ben-hawks/yet-another-smart-vent/docs/images/battery-vent-open-underside.png

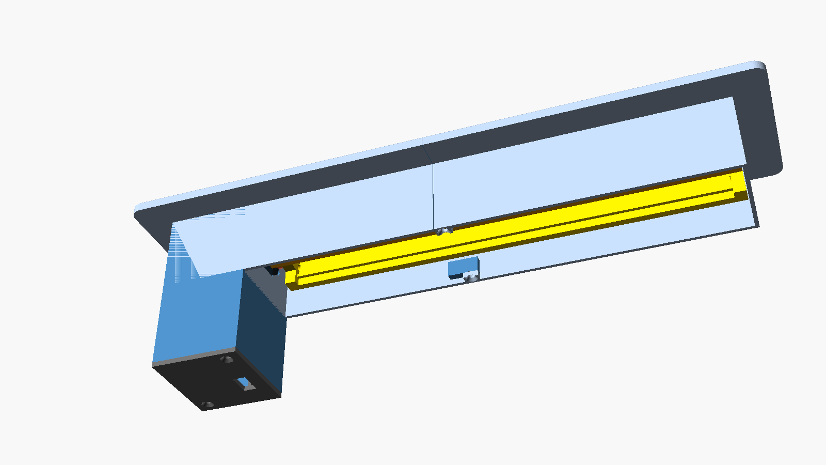
docs/images/battery-vent-open-underside.png
