ben-hawks/yet-another-smart-vent/hardware/xiao-backpack/fab/placement-top.png

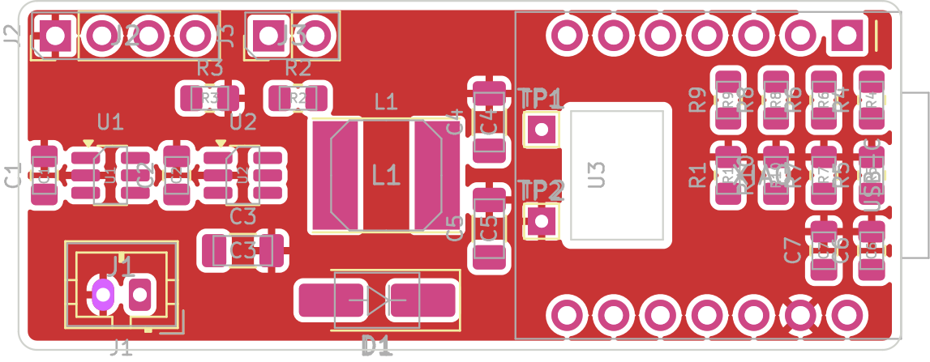
hardware/xiao-backpack/fab/placement-top.png
