ben-hawks/yet-another-smart-vent/docs/bom-10-vents.csv

Group | Reference | Part | Per vent | Qty for 10 | Source | Distributor PN | MPN | Unit price (USD) | Price basis | Notes
Main |  | Seeed XIAO ESP32-C6 | 1 | 10 | DigiKey | 1597-113991254-ND | 113991254 | 5.38 | qty 1
Main |  | Servo metal gear analog feedback (rated -15..70C) | 1 | 10 | Alibaba |  | Feetech FT90M-FB | 6.00 | approx | Must be the 4-wire -FB version
Main |  | Protected 18650 3400mAh button top | 1 | 10 | liionwholesale.com | SW34PCB | Sinowatt SW18650-34MP | 6.37 | qty 10 (user quote) | 69.1 x 18.6 mm; out of stock on 2026-11-01
Main |  | 18650 holder with wire leads | 1 | 10 | DigiKey |  | MPD BH-18650-W | 3.64 | check | Verify protected-cell fit
Main |  | Limit switch | 1 | 10 | DigiKey | P10865S-ND | Panasonic ESE-11HS2 | 0.376 | qty 10
PCB |  | Backpack PCB 48x19mm 2-layer | 1 | 10 | JLCPCB/PCBWay/OSH Park |  |  |  | check | Gerbers in hardware/xiao-backpack/fab/gerbers
PCB | U1 | Load switch | 1 | 10 | DigiKey | 296-50498-1-ND | TI TPS22917DBVR | 0.407 | qty 10
PCB | U2 | Boost converter | 1 | 12 | LCSC | C84817 | MT3608 |  | check | Not stocked by DigiKey
PCB | L1 | 10uH 4.6A Isat shielded 6x6 | 1 | 10 | DigiKey | SRN6045TA-100MCT-ND | Bourns SRN6045TA-100M | 0.408 | qty 10
PCB | D1 | Schottky 40V 3A SMA | 1 | 10 | DigiKey |  | Diodes Inc B340A-13-F | 0.54 | check
PCB | C3 C4 C5 | 22uF 10V X5R 1206 | 3 | 30 | DigiKey | 1276-1287-1-ND | Samsung CL31A226KPHNNNE | 0.283 | qty 10 | 0.188 @100
PCB | C1 | 1uF 25V X7R 0805 | 1 | 20 | DigiKey | 1276-1066-1-ND | Samsung CL21B105KAFNNNE | 0.059 | qty 10
PCB | C6 C7 | 100nF 50V X7R 0805 | 2 | 30 | DigiKey | 1276-1003-1-ND | Samsung CL21B104KBCNNNC | 0.045 | qty 10
PCB | R1 R4 R5 | 1M 1% 0805 | 3 | 50 | DigiKey | 311-1.00MCRCT-ND | Yageo RC0805FR-071ML | 0.034 | qty 10 | 0.017 @100
PCB | R2 | 51k 1% 0805 | 1 | 20 | DigiKey |  | Yageo RC0805FR-0751KL |  | check
PCB | R3 | 6.8k 1% 0805 | 1 | 20 | DigiKey |  | Yageo RC0805FR-076K8L |  | check
PCB | R9 | 1k 1% 0805 | 1 | 20 | DigiKey |  | Yageo RC0805FR-071KL |  | check
PCB | R10 | 100k 1% 0805 | 1 | 20 | DigiKey |  | Yageo RC0805FR-07100KL |  | check
PCB | R6 | 10k 1% 0805 | 1 | 20 | DigiKey |  | Yageo RC0805FR-0710KL |  | check | servo feedback divider
PCB | R7 | 20k 1% 0805 | 1 | 20 | DigiKey |  | Yageo RC0805FR-0720KL |  | check | servo feedback divider
PCB | R8 | 330R 1% 0805 | 1 | 20 | DigiKey |  | Yageo RC0805FR-07330RL |  | check
PCB | J1 | JST PH 2-pin vertical header | 1 | 12 | DigiKey |  | JST B2B-PH-K-S(LF)(SN) | 0.12 | check
PCB |  | JST PH 2-pin housing | 1 | 12 | DigiKey |  | JST PHR-2 | 0.10 | check | For the battery holder lead
PCB |  | JST PH crimp contact | 2 | 30 | DigiKey |  | JST SPH-002T-P0.5S | 0.04 | check | Needs crimper; or solder leads into J1
PCB |  | 1x40 male breakaway header 2.54mm straight | 0.5 | 5 | DigiKey |  | Pololu 965 (or similar) | 0.95 | qty 1 | XIAO pins (soldered directly)
PCB | J2 J3 | 1x40 male header 2.54mm right-angle | 0.2 | 2 | DigiKey |  |  |  | check | 6 pins per board
Hardware |  | M3 heat-set insert 4.6OD x 5.7mm | 9 | 90 | on hand
Hardware |  | M3x8 flat-head screw | 6 | 60 | McMaster/Amazon |  |  |  | check
Hardware |  | M3x10 flat-head screw | 2 | 20 | McMaster/Amazon |  |  |  | check
Hardware |  | M3x16 flat-head screw | 1 | 10 | McMaster/Amazon |  |  |  | check
Hardware |  | ASA or PETG filament | 0.15 kg | 1.5 kg | any |  |  |  | estimate | Not PLA (furnace heat)
