ben-hawks/yet-another-smart-vent/cad/stl/lid.stl

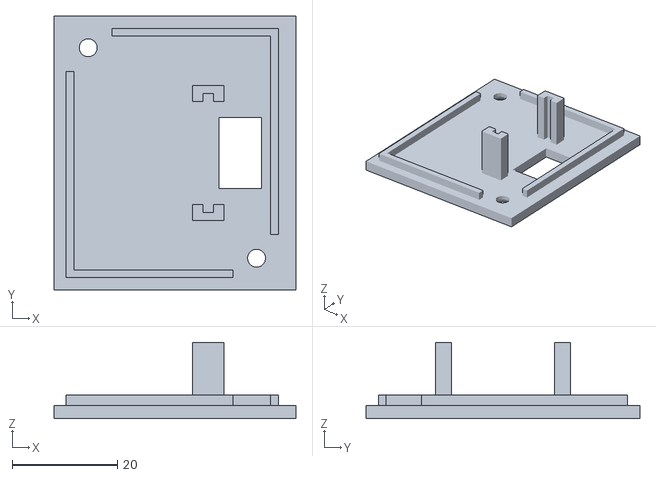
[picture p9: CAD file, 2026-11-01]
cad/stl/lid.stl
46.0 x 52.0 x 14.5
