ben-hawks/yet-another-smart-vent/cad/stl/round6/slat2.stl

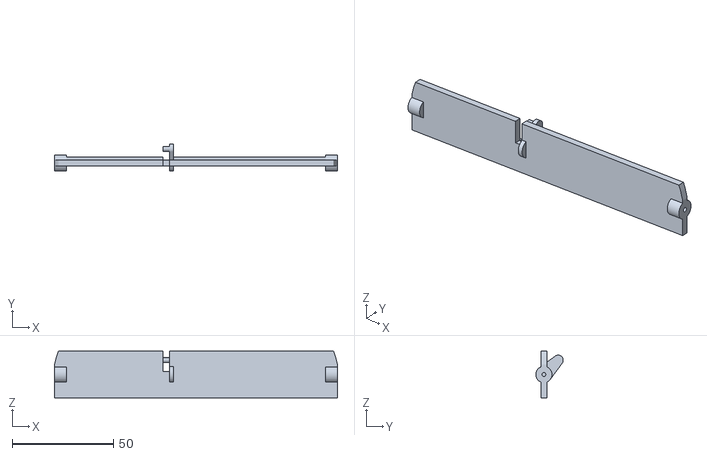
[picture p10: CAD file, 2026-11-01]
cad/stl/round6/slat2.stl
139.8 x 13.6 x 23.0
