ben-hawks/yet-another-smart-vent/cad/stl/body_left.stl

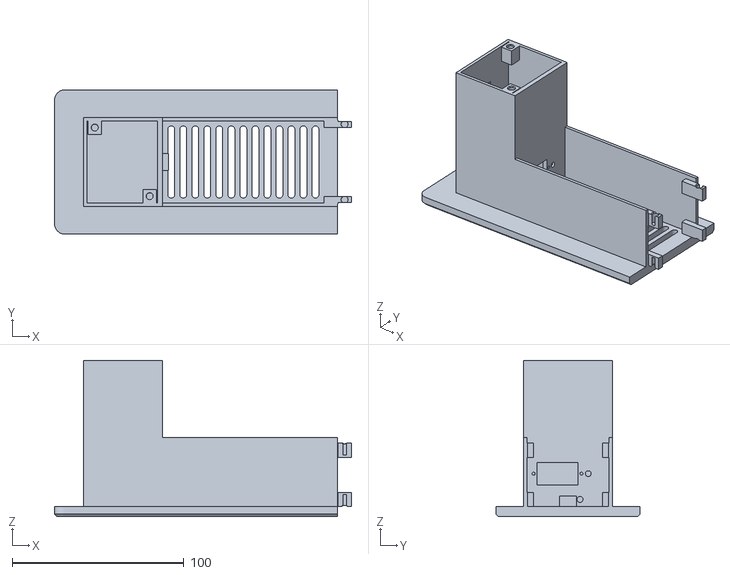
[picture p11: CAD file, 2026-11-01]
cad/stl/body_left.stl
173.0 x 84.0 x 91.0
