ben-hawks/yet-another-smart-vent/cad/stl/round6/slat5.stl

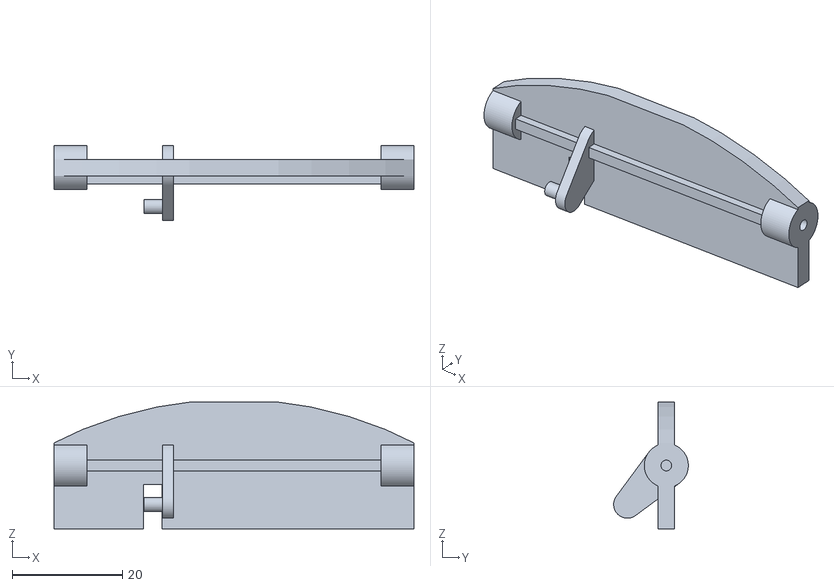
[picture p12: CAD file, 2026-11-01]
cad/stl/round6/slat5.stl
65.4 x 13.6 x 23.0
