ben-hawks/yet-another-smart-vent/cad/stl/louver_follower.stl

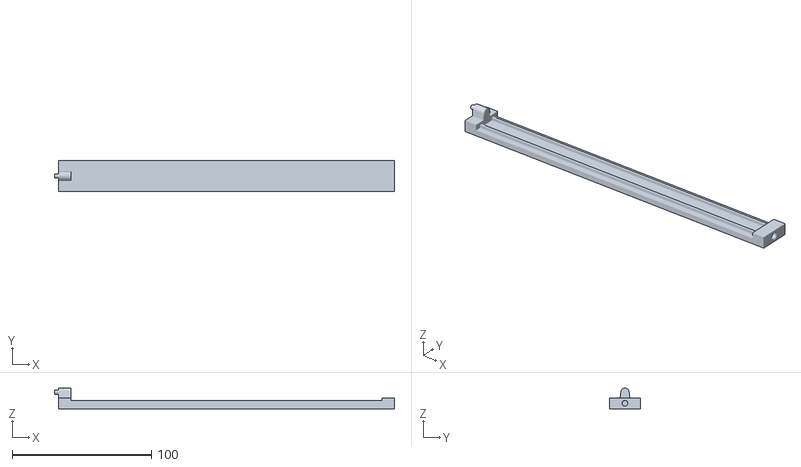
[picture p13: CAD file, 2026-10-31]
cad/stl/louver_follower.stl
243.8 x 22.0 x 15.0
