ben-hawks/yet-another-smart-vent/cad/stl/round6/slat1.stl

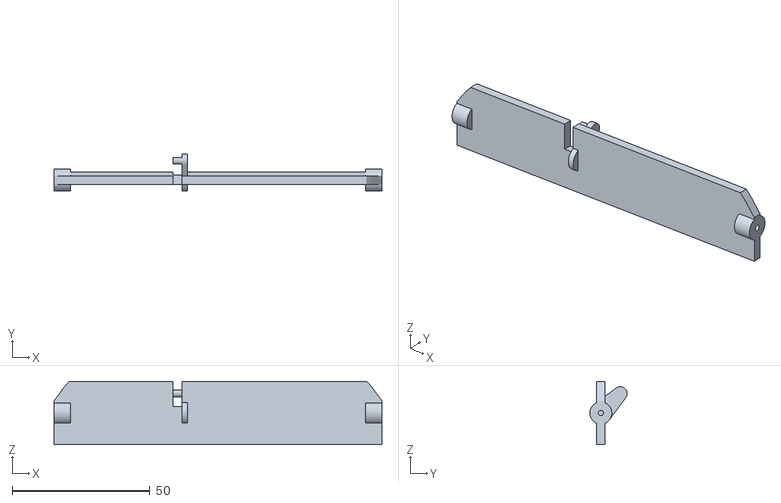
[picture p14: CAD file, 2026-11-01]
cad/stl/round6/slat1.stl
119.1 x 13.6 x 23.0
