ben-hawks/yet-another-smart-vent/cad/stl/body_right.stl

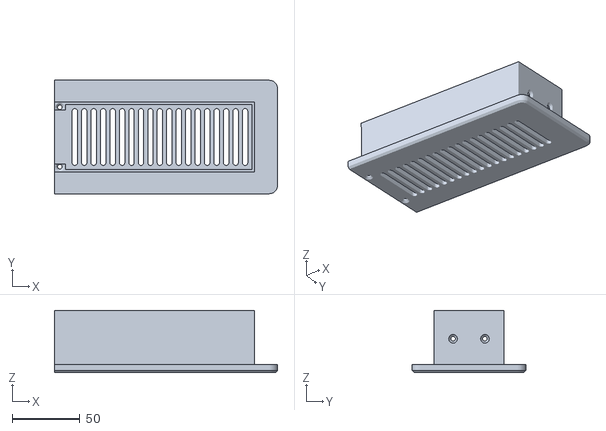
[picture p15: CAD file, 2026-10-31]
cad/stl/body_right.stl
165.0 x 84.0 x 46.0
