ben-hawks/yet-another-smart-vent/cad/stl/fit_test.stl

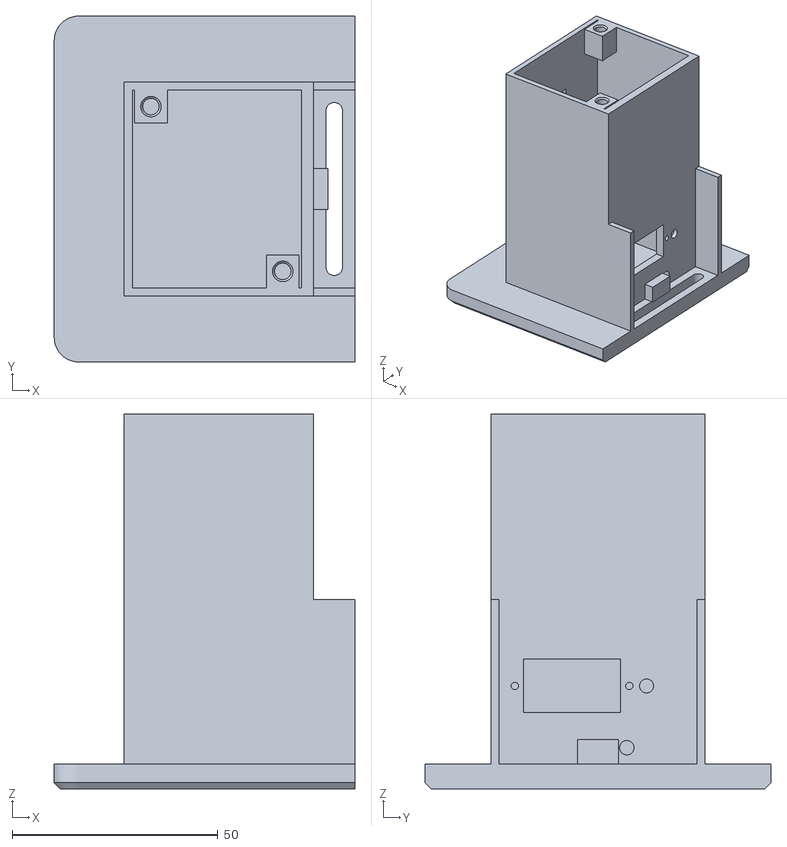
[picture p16: CAD file, 2026-10-31]
cad/stl/fit_test.stl
73.0 x 84.0 x 91.0
