ben-hawks/yet-another-smart-vent/cad/stl/round6/slat4.stl

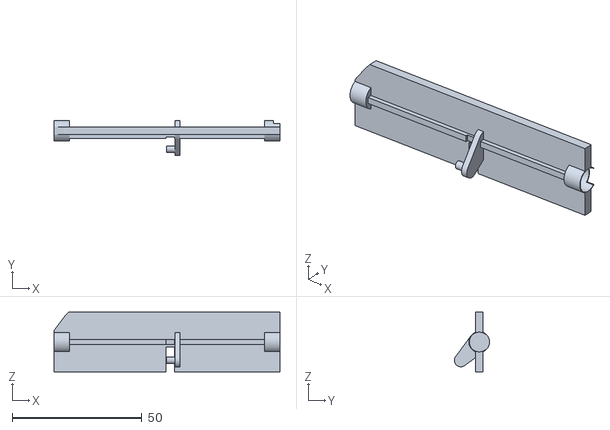
[picture p17: CAD file, 2026-11-01]
cad/stl/round6/slat4.stl
87.1 x 13.6 x 23.0
