ben-hawks/yet-another-smart-vent/cad/stl/link.stl

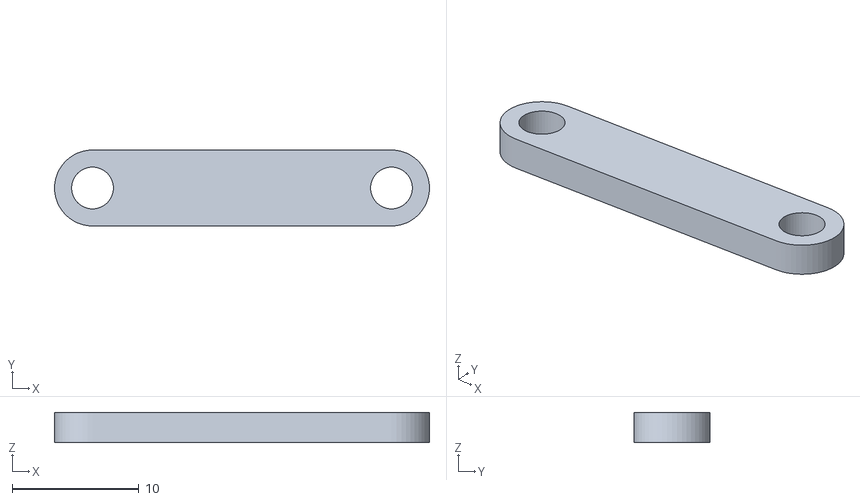
[picture p18: CAD file, 2026-10-31]
cad/stl/link.stl
29.6 x 6.00 x 2.40
