ben-hawks/yet-another-smart-vent/cad/stl/round6/body.stl

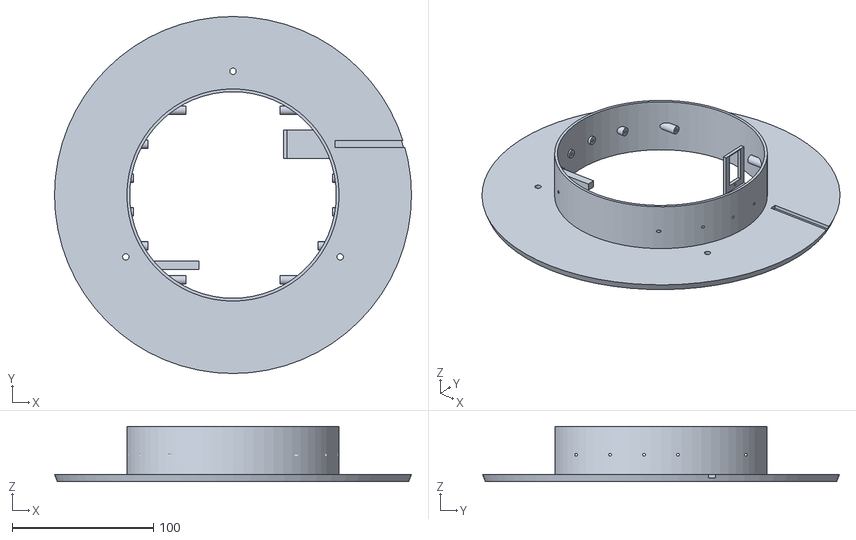
[picture p19: CAD file, 2026-11-01]
cad/stl/round6/body.stl
252.4 x 252.4 x 39.0
