ben-hawks/yet-another-smart-vent/cad/stl/round6/pod_cover.stl

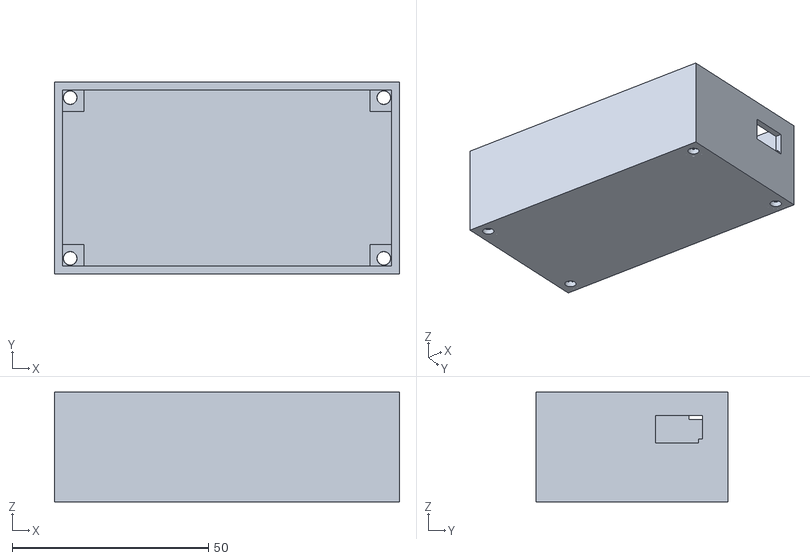
[picture p20: CAD file, 2026-11-01]
cad/stl/round6/pod_cover.stl
88.0 x 49.0 x 28.0
