ben-hawks/yet-another-smart-vent/cad/stl/round6/pod_base.stl

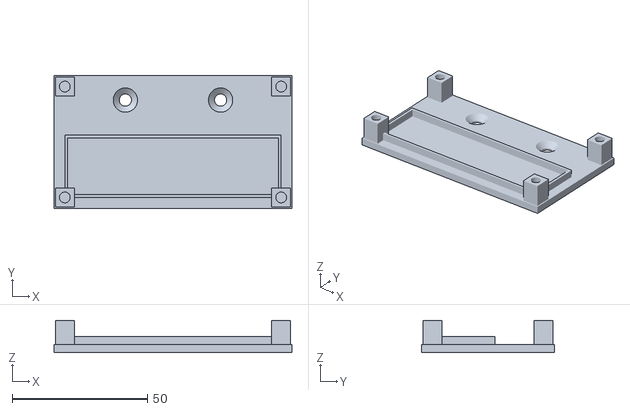
[picture p21: CAD file, 2026-11-01]
cad/stl/round6/pod_base.stl
88.0 x 49.0 x 12.0
