ben-hawks/yet-another-smart-vent/cad/stl/round6/link.stl

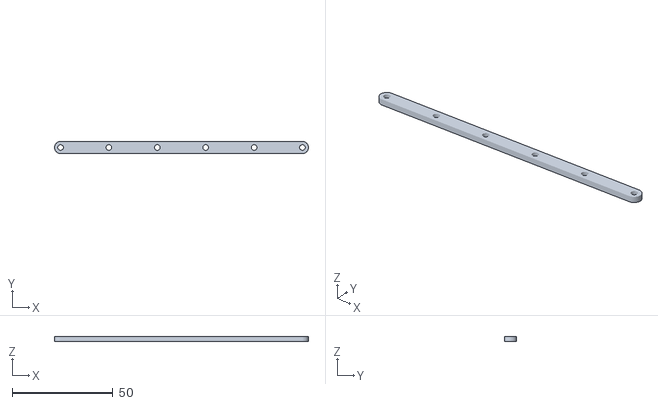
[picture p22: CAD file, 2026-11-01]
cad/stl/round6/link.stl
126.0 x 6.00 x 2.50
