ben-hawks/yet-another-smart-vent/(list of files, cad)

Other CAD files:
cad/stl/round6/slat0.stl
cad/stl/louver_driven.stl
cad/stl/round6/slat3.stl
