ben-hawks/yet-another-smart-vent/hardware/xiao-backpack/fab/smart_vent_backpack_schematic.pdf

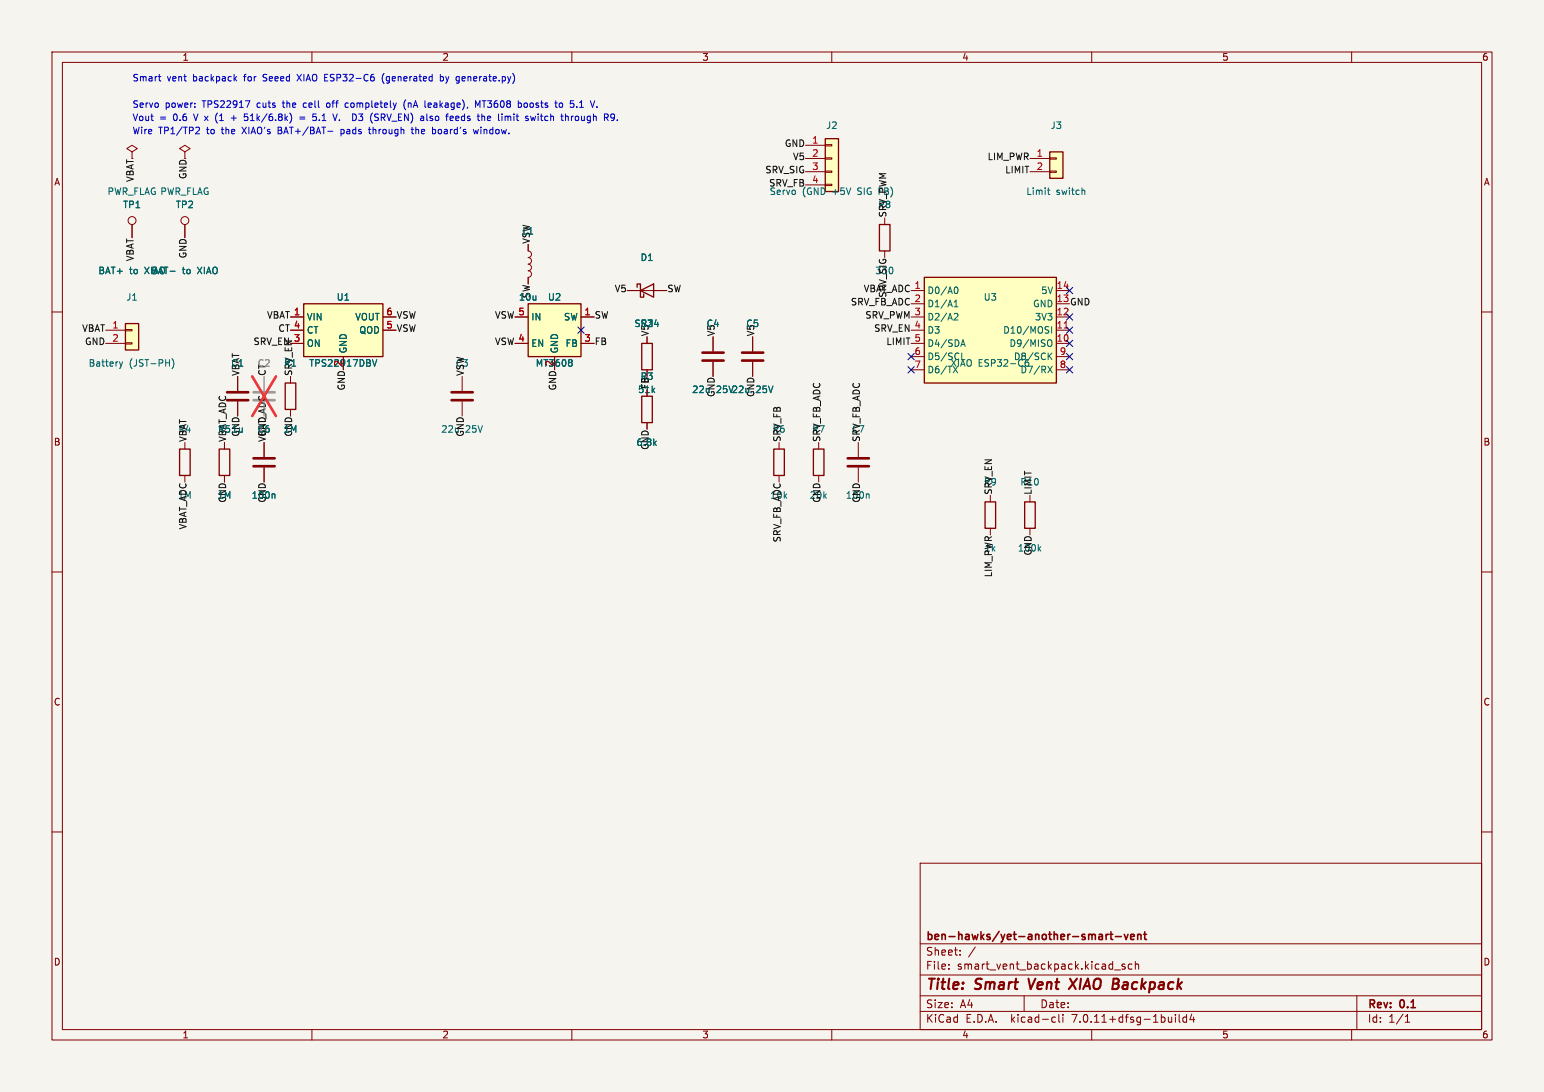
[picture p23: page 1]

2 ON 3 CT 4 QOD 5 VOUT 6 U1 C2 TPS22917DBV

2 ON 3 CT 4 QOD 5 VOUT 6 C2

File: smart_vent_backpack.kicad_sch Sheet: / ben-hawks/yet-another-smart-vent

Id: 1/1 Title: Smart Vent XIAO Backpack
