ben-hawks/yet-another-smart-vent/(list of files, drawings)

Other design files:
hardware/xiao-backpack/fab/smart_vent_backpack.dsn
