ben-hawks/yet-another-smart-vent/hardware/xiao-backpack/smart_vent_backpack.kicad_pcb

## KiCad design hardware/xiao-backpack/smart_vent_backpack.kicad_pcb (2026-11-01)

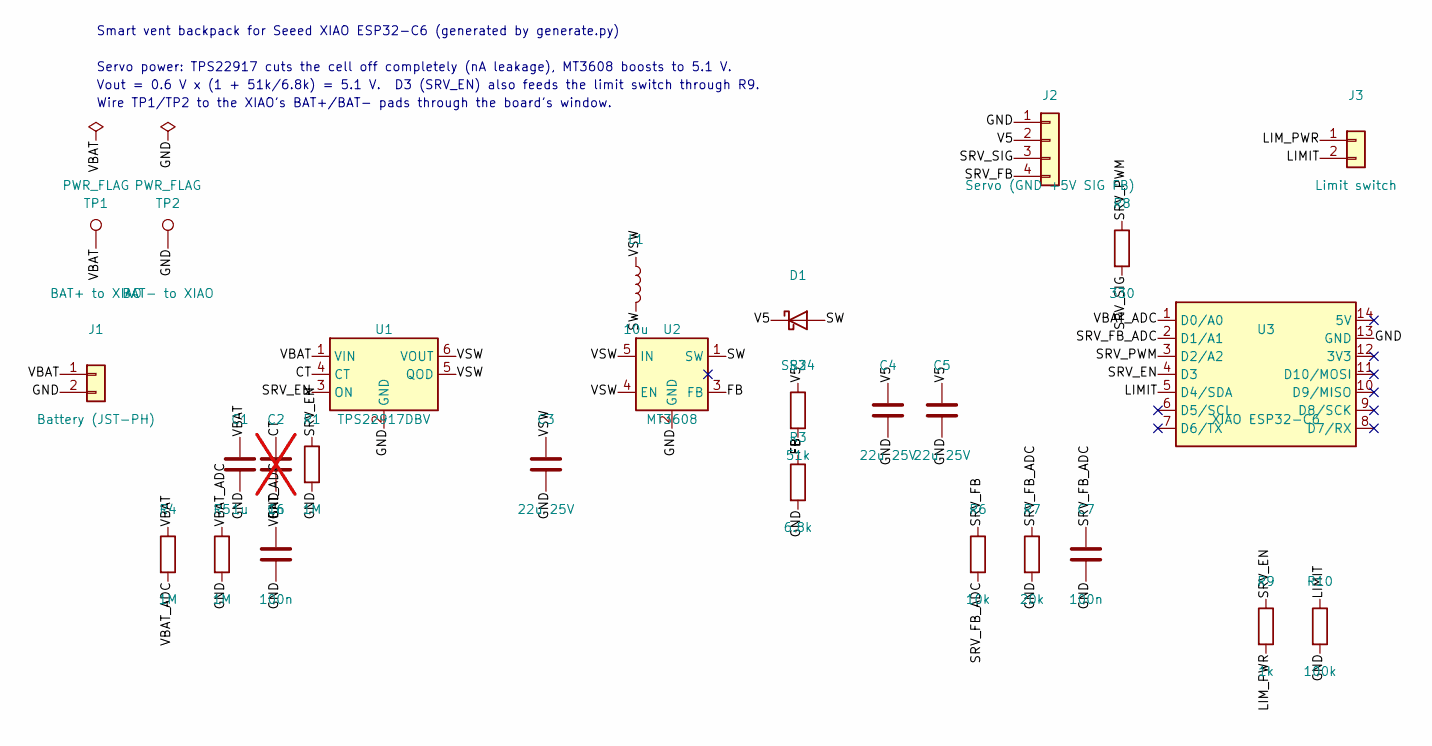
[picture p24: schematic smart_vent_backpack.kicad_sch, Smart Vent XIAO Backpack]

Parts:
C1: 1u; C_0805_2012Metric_Pad1.18x1.45mm_HandSolder
C2: 1n; C_0805_2012Metric_Pad1.18x1.45mm_HandSolder; not fitted
C3, C4, C5: 22u 25V; C_1206_3216Metric_Pad1.33x1.80mm_HandSolder
C6, C7: 100n; C_0805_2012Metric_Pad1.18x1.45mm_HandSolder
D1: SS34; D_SMA_Handsoldering
J1: Battery (JST-PH); JST_PH_B2B-PH-K_1x02_P2.00mm_Vertical
J2: Servo (GND +5V SIG FB); PinHeader_1x04_P2.54mm_Vertical
J3: Limit switch; PinHeader_1x02_P2.54mm_Vertical
L1: 10u; L_Bourns_SRN6045TA_HandSolder
R1, R4, R5: 1M; R_0805_2012Metric_Pad1.20x1.40mm_HandSolder
R2: 51k; R_0805_2012Metric_Pad1.20x1.40mm_HandSolder
R3: 6.8k; R_0805_2012Metric_Pad1.20x1.40mm_HandSolder
R6: 10k; R_0805_2012Metric_Pad1.20x1.40mm_HandSolder
R7: 20k; R_0805_2012Metric_Pad1.20x1.40mm_HandSolder
R8: 330; R_0805_2012Metric_Pad1.20x1.40mm_HandSolder
R9: 1k; R_0805_2012Metric_Pad1.20x1.40mm_HandSolder
R10: 100k; R_0805_2012Metric_Pad1.20x1.40mm_HandSolder
TP1: BAT+ to XIAO; TestPoint_THTPad_1.5x1.5mm_Drill0.7mm
TP2: BAT- to XIAO; TestPoint_THTPad_1.5x1.5mm_Drill0.7mm
U1: TPS22917DBV; SOT-23-6_Handsoldering
U2: MT3608; SOT-23-6_Handsoldering
U3: XIAO ESP32-C6; XIAO_ESP32C6_Backpack

Connections:
CT: C2.1, U1.4 (CT)
FB: R2.2, R3.1, U2.3 (FB)
GND: C1.2, C2.2, C3.2, C4.2, C5.2, C6.2, C7.2, J1.2, J2.1, R1.2, R3.2, R5.2, R7.2, R10.2, TP2.1, U1.2 (GND), U2.2 (GND), U3.13 (GND)
LIMIT: J3.2, R10.1, U3.5 (D4/SDA)
LIM_PWR: J3.1, R9.2
SRV_EN: R1.1, R9.1, U1.3 (ON), U3.4 (D3)
SRV_FB: J2.4, R6.1
SRV_FB_ADC: C7.1, R6.2, R7.1, U3.2 (D1/A1)
SRV_PWM: R8.1, U3.3 (D2/A2)
SRV_SIG: J2.3, R8.2
SW: D1.2 (A), L1.2, U2.1 (SW)
V5: C4.1, C5.1, D1.1 (K), J2.2, R2.1
VBAT: C1.1, J1.1, R4.1, TP1.1, U1.1 (VIN)
VBAT_ADC: C6.1, R4.2, R5.1, U3.1 (D0/A0)
VSW: C3.1, L1.1, U1.5 (QOD), U1.6 (VOUT), U2.4 (EN), U2.5 (IN)

Notes on the sheet:
Smart vent backpack for Seeed XIAO ESP32-C6 (generated by generate.py)
Servo power: TPS22917 cuts the cell off completely (nA leakage), MT3608 boosts to 5.1 V.
Vout = 0.6 V x (1 + 51k/6.8k) = 5.1 V. D3 (SRV_EN) also feeds the limit switch through R9.
Wire TP1/TP2 to the XIAO's BAT+/BAT- pads through the board's window.

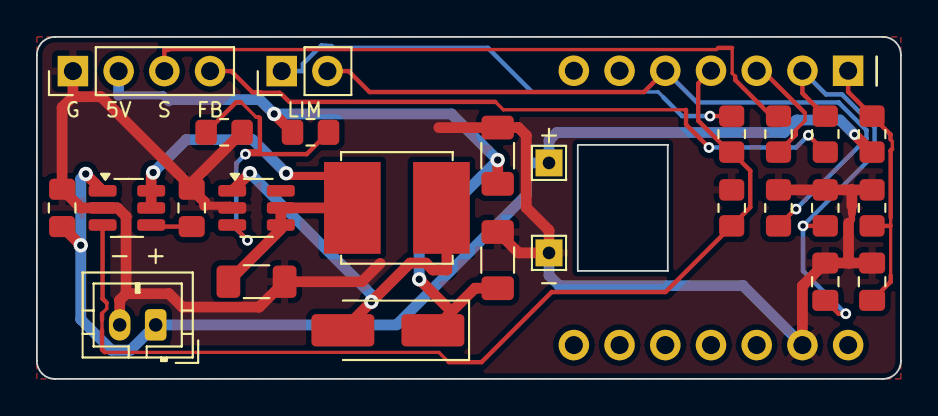
[picture p25: board smart_vent_backpack.kicad_pcb from above]

Board: 2 copper layers, 48.0 x 19.0 mm, 27 parts (0 on the bottom side), 15 nets.
