ben-hawks/yet-another-smart-vent/(commit log)

2026-10-31 Add battery/Thread firmware for XIAO ESP32-C6 smart vent
    Adds a sleepy-end-device Thread configuration with a power-gated servo,
    battery monitoring, persistent calibration and an HA-unreachable fail-safe,
    plus a small external component that enables ESP-IDF light sleep.
    Claude-Session: https://claude.ai/code/session_01MuCkd3cNqpTftDkBvBdVHU
    [smart-vent-thread-battery-base.yaml]
2026-10-31 Pass Thread dataset in via substitution
    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
2026-10-31 Add parametric 2x12 battery vent model and bay temperature sensor
    Original OpenSCAD design: split grille/body joined with M3 heat-set
    inserts, two full-length louvers driven by a power-gated servo through a
    parallel crank linkage, and a lidded electronics tower holding an 18650
    and the XIAO ESP32-C6.
    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
    [body_left.stl, body_right.stl, lid.stl, link.stl, louver_driven.stl, louver_follower.stl, smart_vent_2x12_battery.scad]
2026-10-31 Document the battery/Thread vent and export STLs
    Adds build docs (BOM, wiring, power budget, furnace heat notes, test plan),
    renders, a CAD readme, and fixes the electronics tower being filled solid.
    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
    [body_left.stl, body_right.stl, fit_test.stl, lid.stl, louver_driven.stl, louver_follower.stl]
2026-10-31 Add Thread rewrite of Delta Tango and an HVAC vent safety blueprint
    XIAO ESP32-C6 supply/return monitor (one DS18B20 per pin, Thread router)
    plus an HA blueprint that opens the smart vents on high heating rise, a
    cold coil while cooling, or a lost sensor. Docs include the rated-rise
    analysis for an Ameristar M801P080BU36.
    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
2026-10-31 Fit the model to the real inserts and boot depth
    Inserts are M3 x 4.6 OD x 5.7 mm: holes stay 4.0 mm but go 7 mm deep, louver
    end blocks grow to 9 mm so the holes stay enclosed, and screw lengths in the
    BOM are corrected (follower axle M3x16, far-end axles and lid M3x8). Adds the
    measured 4-inch boot depth with a render-time check that the tower fits.
    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
    [body_left.stl, body_right.stl, fit_test.stl, louver_driven.stl, louver_follower.stl, smart_vent_2x12_battery.scad]
2026-10-31 Add KiCad backpack board for the XIAO ESP32-C6 (placed, unrouted)
    generate.py builds the schematic, placed 2-layer PCB, net classes, ground
    pours, Gerbers and BOM from one parts table, and checks the schematic
    netlist against the PCB and runs DRC (0 violations; routing still to do).
    Circuit: TPS22917 load switch + MT3608 5.1 V boost for the servo, battery
    and servo-feedback dividers, limit switch feed, JST-PH battery input.
    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
    [bom.csv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]
2026-10-31 Backpack: put power nets in the Power class for the router; fab rules
    KiCad 7's DSN exporter left every net in kicad_default, so the first
    autoroute used 0.25 mm traces for the boost converter's 1 A+ paths. The
    DSN now lists GND/SW/V5/VBAT/VSW under Power (0.6 mm, 0.8/0.4 vias), the
    SES importer reads multi-line paths, and the board carries fab-friendly
    limits (0.3 mm edge, 0.12 mm min track). Board left unrouted pending a
    re-route of the corrected DSN.
    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
    [smart_vent_backpack-B_Cu.gbl, smart_vent_backpack-B_Mask.gbs, smart_vent_backpack-B_Paste.gbp, smart_vent_backpack-B_Silkscreen.gbo, smart_vent_backpack-Edge_Cuts.gm1, smart_vent_backpack-F_Cu.gtl, smart_vent_backpack-F_Mask.gts, smart_vent_backpack-F_Paste.gtp]
2026-11-01 Re-route XIAO backpack with power net class
2026-11-01 Switch to the SER0046 feedback servo and add a 10-vent BOM
    SER0039 (the DigiKey MG90 link) has no feedback wire; SER0046 does (0-3.3 V,
    270 deg). The backpack's feedback divider becomes 1k series + 100k pull-down
    (values only, no netlist change), the firmware's 90 degree distance becomes
    0.67, and docs/BOM.md + bom-10-vents.csv list DigiKey/LCSC/DFRobot parts with
    the prices that were confirmed.
    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
    [bom-10-vents.csv, bom.csv, smart_vent_2x12_battery.scad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]
2026-11-01 Backpack: import the power-class re-route; DRC clean
    Imports Freerouting's re-route (233 tracks, 18 vias, power nets at 0.6 mm),
    drops the two GND tracks that sat 0.23 mm from the battery-wire window (both
    layers are GND-poured), and regenerates Gerbers, a zipped set, and renders.
    KiCad 7: 0 DRC violations, 0 unconnected pads, schematic/PCB nets match.
    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
    [smart_vent_backpack-B_Cu.gbl, smart_vent_backpack-B_Mask.gbs, smart_vent_backpack-B_Paste.gbp, smart_vent_backpack-B_Silkscreen.gbo, smart_vent_backpack-Edge_Cuts.gm1, smart_vent_backpack-F_Cu.gtl, smart_vent_backpack-F_Mask.gts, smart_vent_backpack-F_Paste.gtp]
2026-11-01 Backpack: proper hand-solder footprint for the SRN6045TA inductor
    The BOM's Bourns SRN6045TA-100M sat on a Taiyo Yuden NR-60xx land pattern,
    whose pads are ~0.7 mm further out than the Bourns terminals. L1 now uses the
    Bourns land pattern with pads extended 0.8 mm outward for an iron. GND tracks
    the router had run between the old pads are dropped on import (pours carry
    GND). KiCad 7: 0 DRC violations, 0 unconnected, nets match. README gains a
    hand-soldering order and a 5 V bring-up check.
    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
    [bom.csv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]
2026-11-01 Backpack: JLCPCB assembly files (BOM + CPL) with checked LCSC parts
    generate.py now writes fab/jlcpcb/bom_jlcpcb.csv and cpl_jlcpcb.csv for the
    21 SMD parts (through-hole connectors stay hand-soldered), with LCSC numbers
    checked against JLCPCB's parts API and SOT-23 rotations corrected. The boost
    feedback becomes 51k/6.8k (same 5.1 V, both JLCPCB Basic parts) and the 22 uF
    caps are the 25 V Basic part; only TPS22917, MT3608 and SRN6045TA are
    Extended. DRC still clean, nets match.
    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
    [bom-10-vents.csv, bom.csv, bom_jlcpcb.csv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]
2026-11-01 Design review fixes before ordering the backpack
    - C2 (TPS22917 CT) is DNP: TI specifies the CT cap from CT to VIN, the board
    had it to GND. CT floats (allowed, ~120 us turn-on); removed from BOM/CPL.
    - Silkscreen connector labels: servo pins (G 5V S FB), LIM, battery +/-,
    BAT wire pads +/- on both sides.
    - Enclosure: lid cradle now holds the 48x19 mm backpack (USB-C opening
    located from the XIAO stack), liner 2 mm, and render-time asserts that the
    stack clears the cell holder, partition and servo.
    - BOM: XIAO soldered directly (no sockets), right-angle J2/J3 headers.
    Datasheet checks (TPS22917, MT3608, ESP32-C6 strapping/ADC) recorded in the
    board README. KiCad 7: 0 DRC violations,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
    [bom-10-vents.csv, bom.csv, bom_jlcpcb.csv, lid.stl, smart_vent_2x12_battery.scad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]
2026-11-01 Add Delta Tango parts list and build guide
    delta-tango/BUILD.md: BOM (XIAO ESP32-C6, 2x DS18B20 probes, pull-ups,
    terminals), wiring with one probe per pin, probe placement and duct safety,
    ESPHome/HA setup including the safety blueprint threshold for the Ameristar
    M801P080BU36 (30-60 F rated rise), and commissioning checks.
    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
2026-11-01 Add a 6" round ceiling vent: louvered damper with a side battery pod
    cad/smart_vent_round6_ceiling.scad: original parametric model for a
    6" round ceiling diffuser replacement (AmeriFlow 1500W6 size, 3-screw
    mount). Six circle-shaped louvers on filament pins, a link bar whose cranks
    swing -45..+45 deg (no dead point) through slots in the louvers, the SER0046
    servo driving one louver, a limit switch pressed by slat 0 when closed, and a
    separate ceiling-mounted pod for the 18650 and backpack board. Checked for
    collisions between every pair of parts at 0-90 deg in 15 deg steps. STLs,
    renders and docs/ROUND_CEILING_VENT.md included.
    Claude-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
    [body.stl, link.stl, pod_base.stl, pod_cover.stl, slat0.stl, slat1.stl, slat2.stl, slat3.stl]
2026-11-01 Switch to the Feetech FT90M-FB servo (metal gear, rated -15..70 C)
    The DFRobot SER0046 is only rated to 50 C, below gas-furnace supply air at
    the top of the rated rise (~54 C). The FT90M-FB keeps metal gears and a
    0.04-3.2 V feedback wire, is rated -15..70 C, is the same micro size, and is
    about $6 on Alibaba. Firmware 90-degree distance becomes 0.71 (280 deg over
    ESPHome's 0.6-2.4 ms default range); both CAD models take its 23.2 mm body
    (round vent re-checked: servo clears every louver from 0 to 90 deg).
    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
    [body.stl, body_left.stl, bom-10-vents.csv, smart_vent_2x12_battery.scad, smart_vent_round6_ceiling.scad]
2026-11-01 Divide the FT90M-FB feedback: Feetech's sheet shows up to 4.45 V
    Feetech's FT90M spec sheet lists feedback of 0.85 V / 1.65 V / 4.45 V at
    900 / 1500 / 2100 us (its web page said 0.04-3.2 V). 4.45 V would exceed the
    ESP32-C6 ADC/GPIO limit through the 1k/100k front end, so R6/R7 become a
    10k/20k divider again (5.1 V -> 3.4 V, 4.45 V -> 2.97 V), both JLCPCB Basic
    (C17414, C4328). Values only; routing unchanged, DRC clean, nets match.
    Also takes the sheet's 16.8 mm below-tab depth and 8.7 mm spline height into
    the 2x12 model.
    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
    [body_left.stl, bom-10-vents.csv, bom.csv, bom_jlcpcb.csv, lid.stl, smart_vent_2x12_battery.scad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]
2026-11-01 Round vent: print each louver on its straight, centre-side edge
    Slats 0-2 were exported with their circle-cut outer edge on the bed
    (slat 0 touched only ~49 mm2). Flip the -Y slats so the long straight
    edge is always down: slat 0 bed contact 49 -> 196 mm2, and the cut ends
    lean inward instead of overhanging.
    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
    [slat0.stl, slat1.stl, slat2.stl, slat3.stl, slat4.stl, slat5.stl, smart_vent_round6_ceiling.scad]
